fedorenkoalex/CIVP30OBD_BT/Images/20x4 disp.jpg

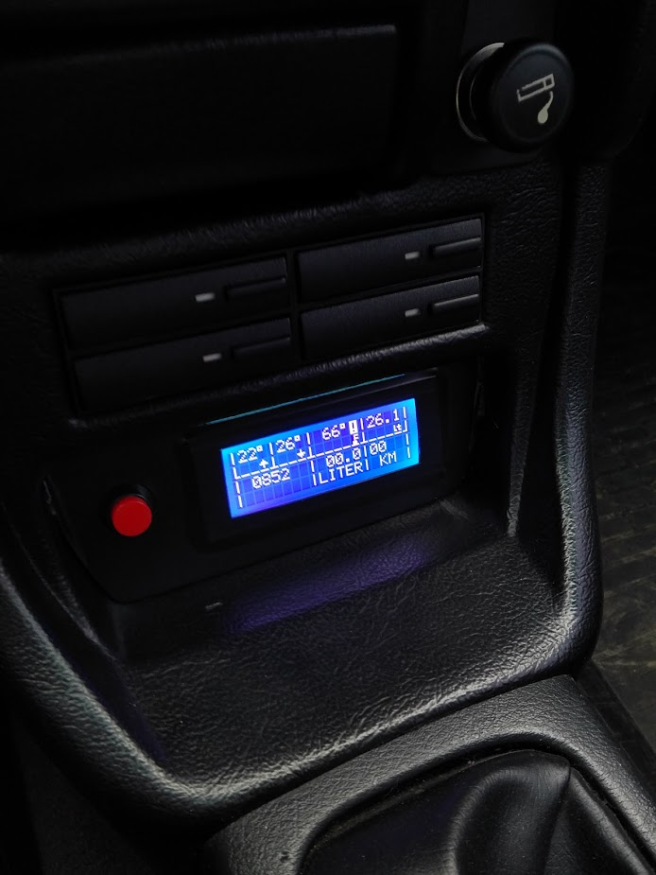
Images/20x4 disp.jpg
