fedorenkoalex/CIVP30OBD_BT/Images/Honda OBD I Codes.png

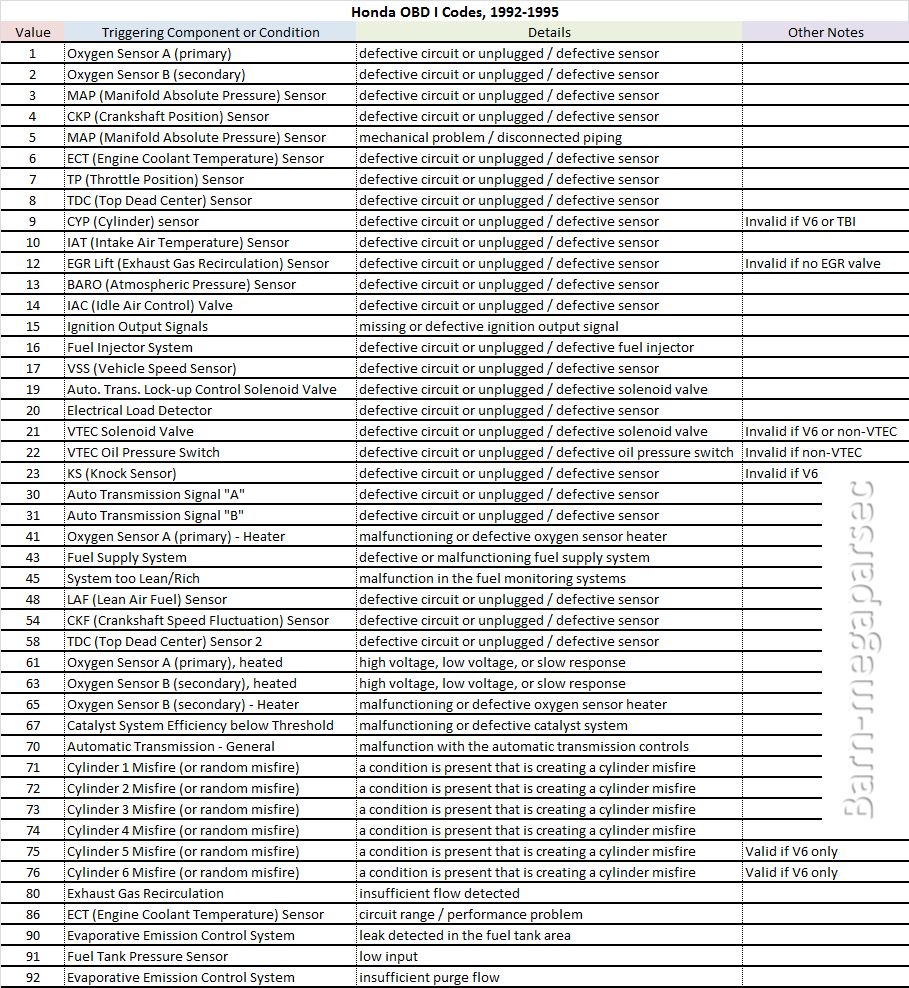
Images/Honda OBD I Codes.png
