fedorenkoalex/CIVP30OBD_BT/Images/photo_2018-02-14_15-03-05.jpg

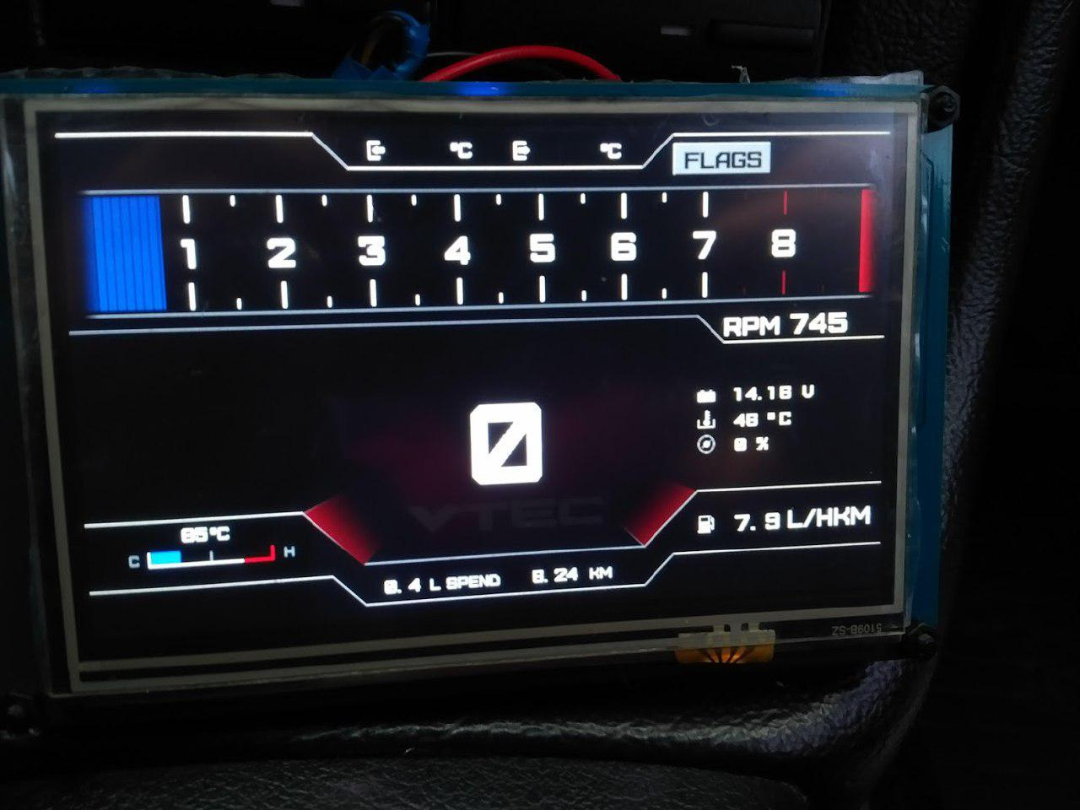
Images/photo_2018-02-14_15-03-05.jpg
