fedorenkoalex/CIVP30OBD_BT/Images/photo_2018-02-18_15-41-23.jpg

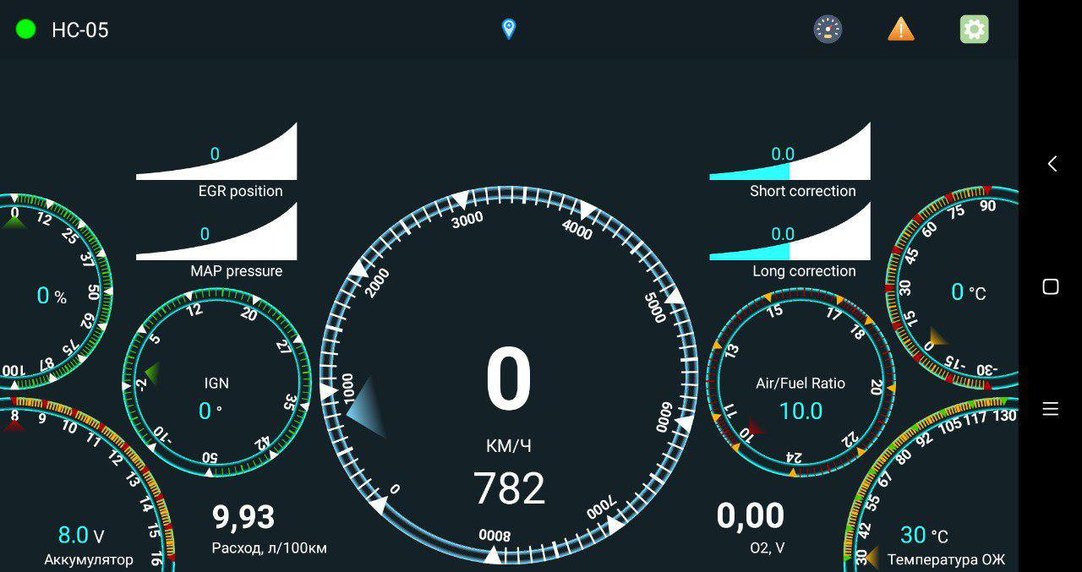
Images/photo_2018-02-18_15-41-23.jpg
