fedorenkoalex/CIVP30OBD_BT/(threads)

Thread 2 (2024-03-06):

IMA Voltage

ekoninsp, 2024-03-06:
Hi.. Alex,
if I use universal car scanner that support to read Honda OBD1 ECU like : autoboss, xtools etc..
I can see output of IMA sensor/voltage (settings for the fuel and air mixture in openloop system).
Based on your writing about ECU response on P30. Do you know how can we get the output of IMA voltage value?
--Thank you..

fedorenkoalex, 2024-03-06:
Hi, @ekoninsp
I worked on this project 5 years ago and did not investigate this topic for a long time.
I am not sure that I can help you with this.
I don’t even have a car anymore to test this😀

Closed 2024-03-06.
